dimembermatt/mighty-mppt/hardware/mppt/models/molex_43650_0315.stp

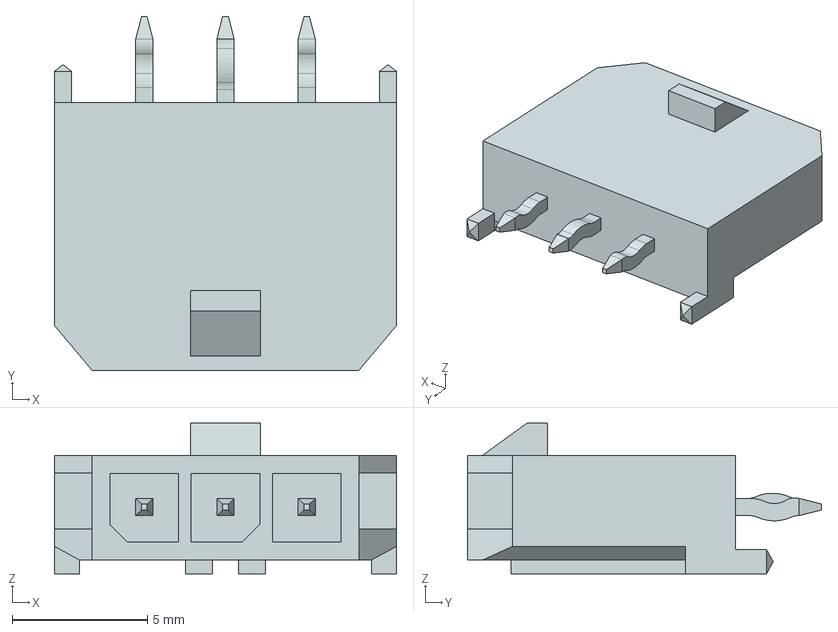
[picture p1: CAD file, 2024-09-21]
hardware/mppt/models/molex_43650_0315.stp
12.7 x 13.1 x 5.57 mm
