dimembermatt/mighty-mppt/hardware/mppt/symbols/tdk_B65878E1012D001.stp

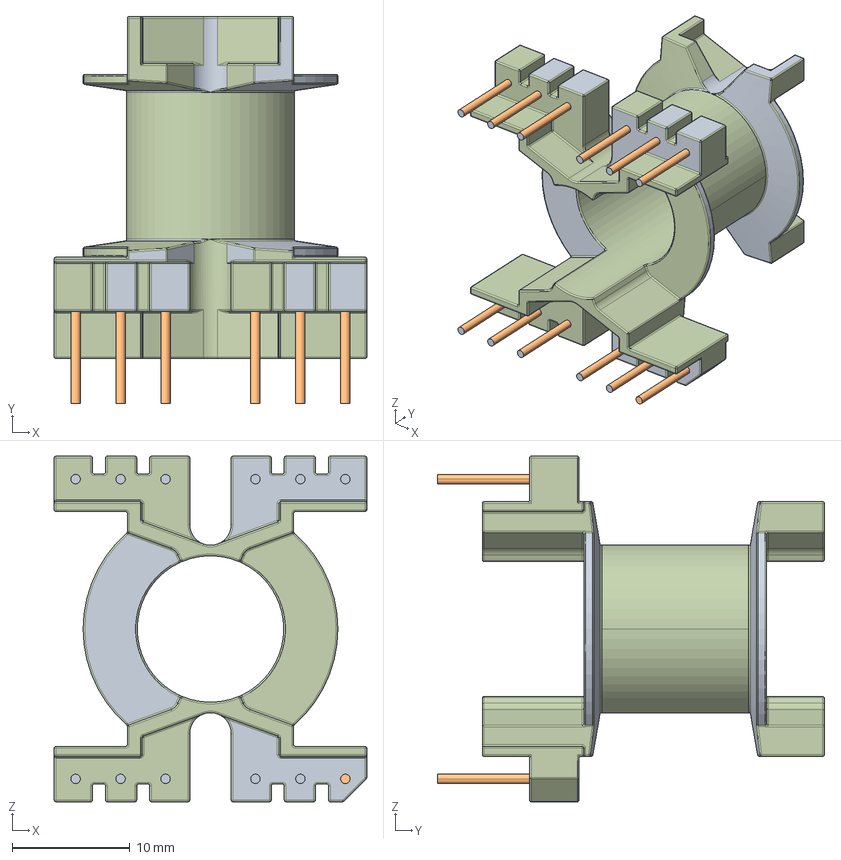
[picture p2: CAD file, 2024-09-21]
hardware/mppt/symbols/tdk_B65878E1012D001.stp
26.5 x 32.8 x 29.3 mm
