dimembermatt/mighty-mppt/hardware/mppt/models/molex_43650_0215.stp

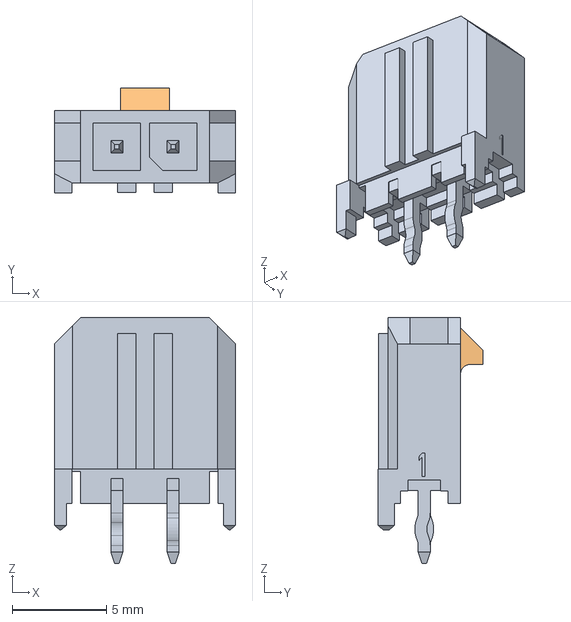
[picture p3: CAD file, 2024-09-21]
hardware/mppt/models/molex_43650_0215.stp
9.65 x 5.61 x 13.1 mm
