dimembermatt/mighty-mppt/hardware/mppt/models/molex_43650_0415.stp

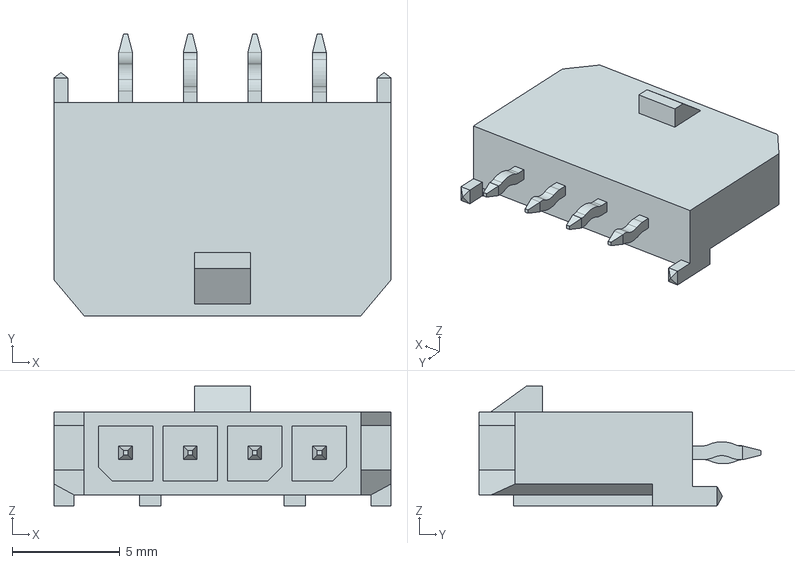
[picture p4: CAD file, 2024-09-21]
hardware/mppt/models/molex_43650_0415.stp
15.7 x 13.1 x 5.57 mm
