dimembermatt/mighty-mppt/hardware/mppt/models/abracon_ABS2.step

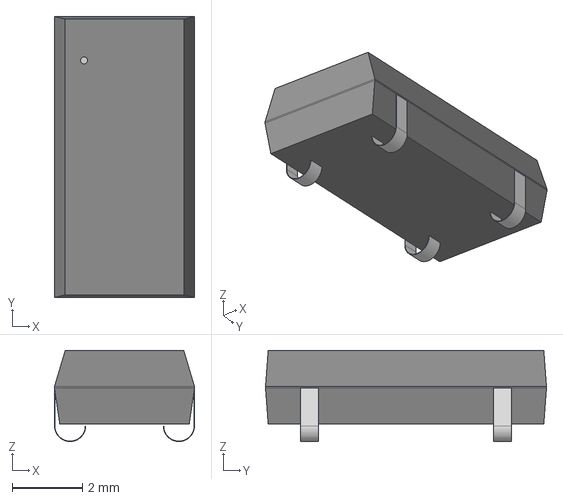
[picture p5: CAD file, 2024-09-21]
hardware/mppt/models/abracon_ABS2.step
3.99 x 8.00 x 2.59 mm
