dimembermatt/mighty-mppt/hardware/mppt/models/ke_7771_SEMS.stp

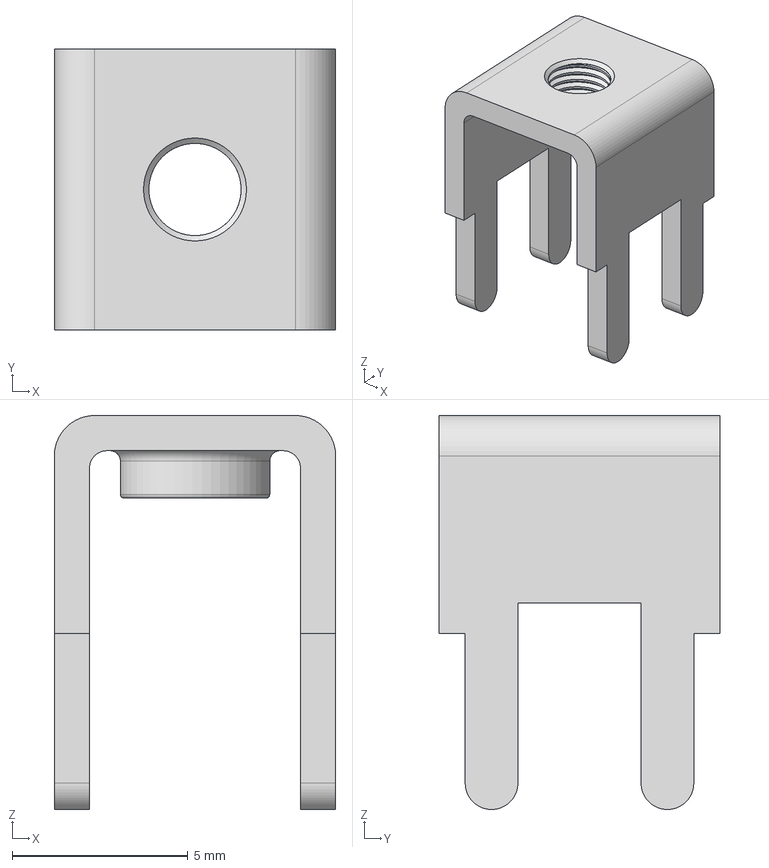
[picture p6: CAD file, 2024-09-02]
hardware/mppt/models/ke_7771_SEMS.stp
8.00 x 8.00 x 11.2 mm
