dimembermatt/mighty-mppt/hardware/mppt/models/ti_SN74HCS367_PWR.stp

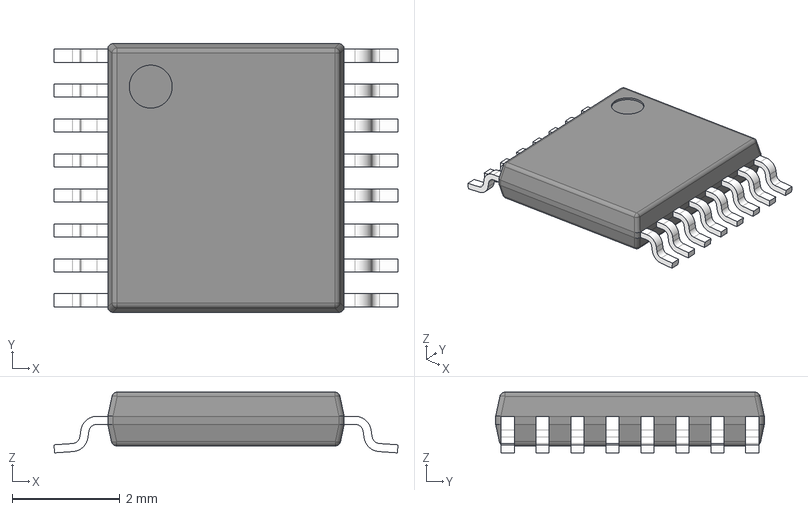
[picture p7: CAD file, 2024-08-27]
hardware/mppt/models/ti_SN74HCS367_PWR.stp
6.40 x 5.00 x 1.13 mm
BODY-TSSOP
LEAD-TSSOP x 16
PIN1
