dimembermatt/mighty-mppt/hardware/mppt/models/ti_ISO6720B_DR.stp

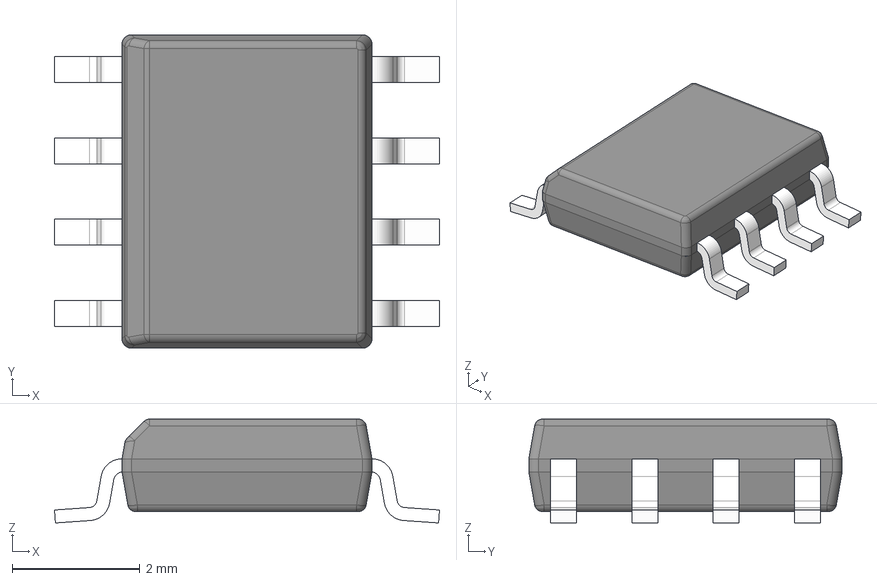
[picture p8: CAD file, 2024-08-27]
hardware/mppt/models/ti_ISO6720B_DR.stp
6.02 x 4.90 x 1.63 mm
BODY-SO
LEAD-D0008B x 8
