dimembermatt/mighty-mppt/hardware/mppt/models/ti_SN74LVC2G32_DCUR.stp

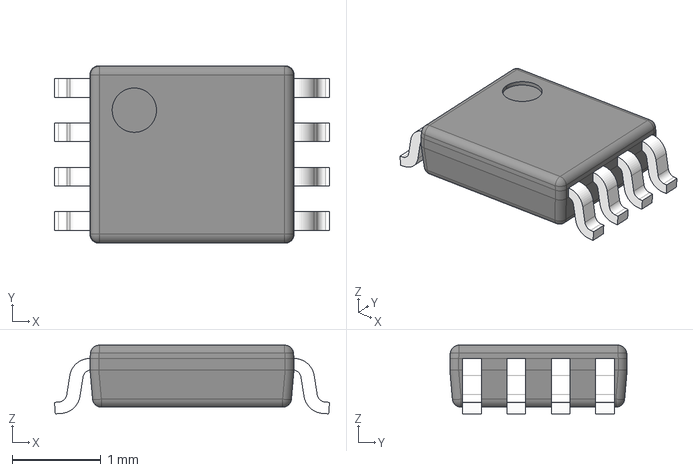
[picture p9: CAD file, 2024-08-27]
hardware/mppt/models/ti_SN74LVC2G32_DCUR.stp
3.10 x 2.00 x 0.775 mm
BODY-VSSOP
LEAD-VSSOP x 8
