dimembermatt/mighty-mppt/hardware/mppt/models/ti_INA229_AIDGSR.stp

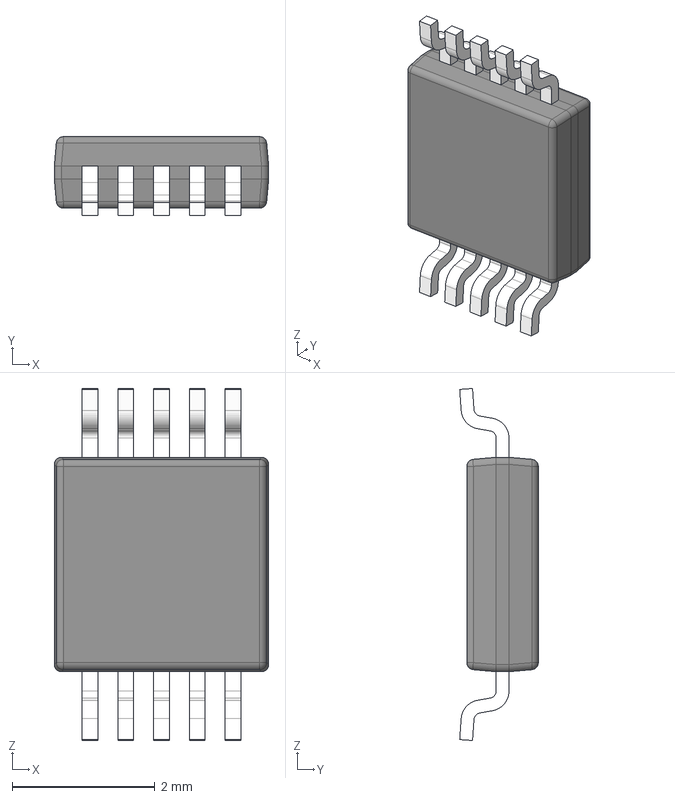
[picture p10: CAD file, 2024-08-27]
hardware/mppt/models/ti_INA229_AIDGSR.stp
3.00 x 1.10 x 4.93 mm
BODY-SO
LEAD-SO x 10
PIN1-ID
