dimembermatt/mighty-mppt/hardware/mppt/models/ti_TPS3050_DWZ.stp

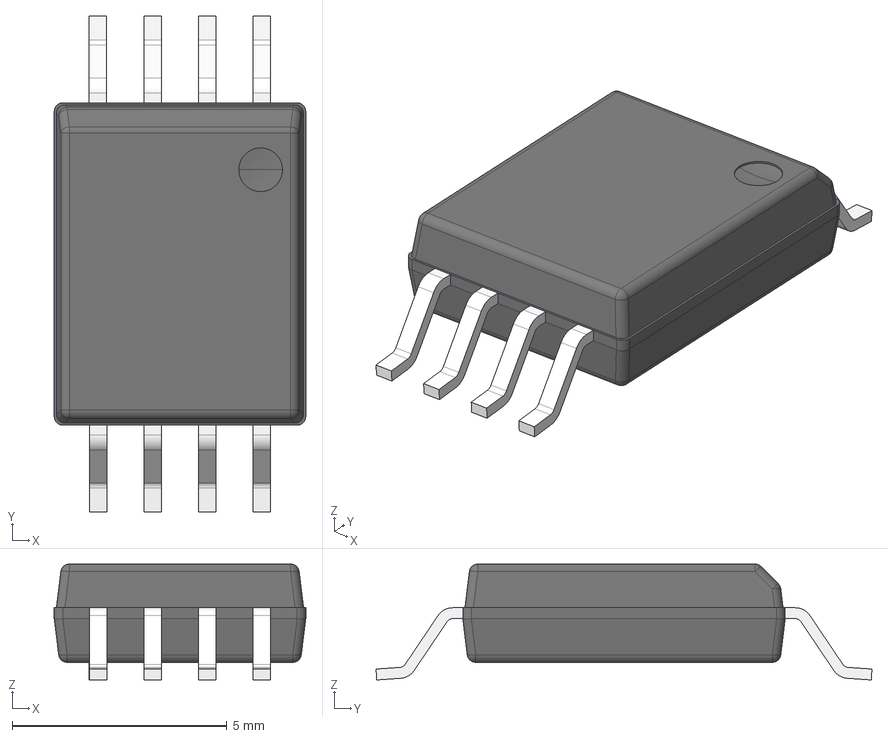
[picture p11: CAD file, 2024-08-27]
hardware/mppt/models/ti_TPS3050_DWZ.stp
5.85 x 11.5 x 2.70 mm
BODY-SOIC
LEAD x 8
