dimembermatt/mighty-mppt/hardware/mppt/models/ti_SN74LVC08A_PWR.stp

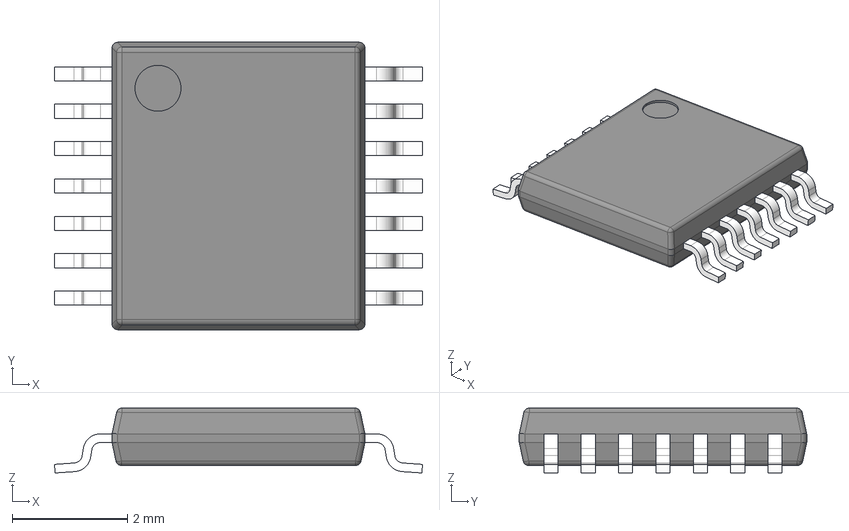
[picture p12: CAD file, 2024-08-27]
hardware/mppt/models/ti_SN74LVC08A_PWR.stp
6.40 x 5.00 x 1.13 mm
BODY-TSSOP
LEAD-TSSOP x 14
PIN1
