dimembermatt/mighty-mppt/hardware/mppt/models/ti_SN74LVC1G04_DBVR.stp

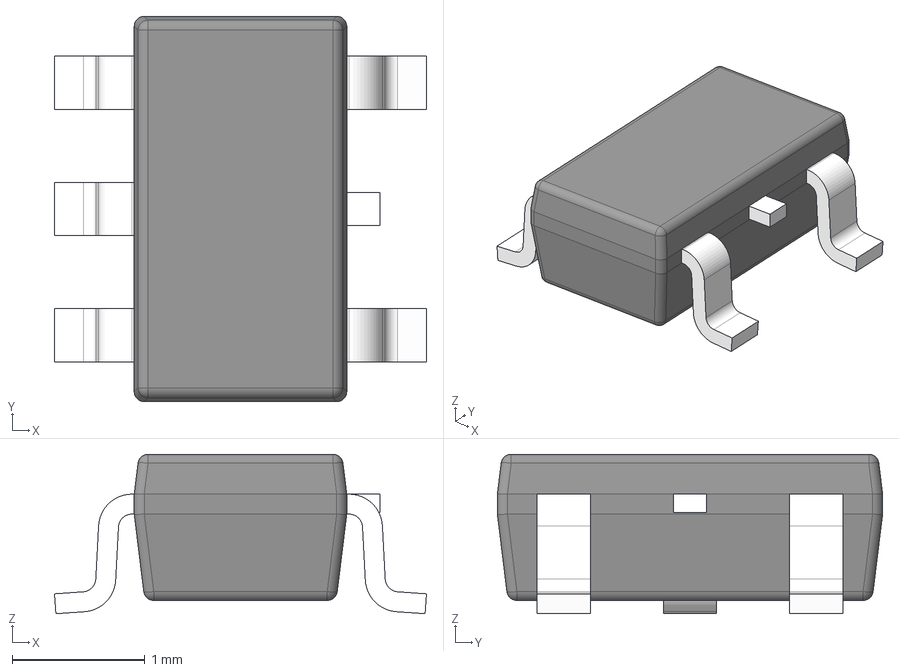
[picture p13: CAD file, 2024-08-27]
hardware/mppt/models/ti_SN74LVC1G04_DBVR.stp
2.80 x 2.90 x 1.20 mm
BODY-SOT
LEAD-SOT x 5
LEAD-DUMMY
