dimembermatt/mighty-mppt/hardware/mppt/models/ferroxcube_CPV-PQ32_20-1S-12P-Z.stp

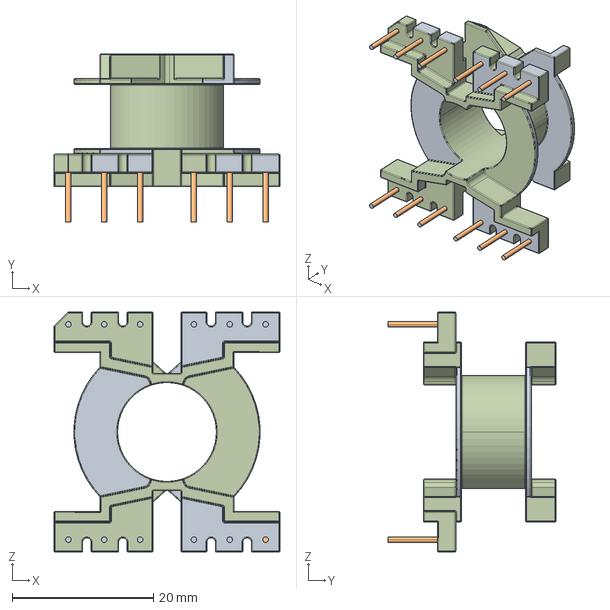
[picture p14: CAD file, 2024-08-25]
hardware/mppt/models/ferroxcube_CPV-PQ32_20-1S-12P-Z.stp
32.0 x 23.8 x 34.0 mm
