dimembermatt/mighty-mppt/hardware/mppt/models/bourns_PV36W104C01B00.stp

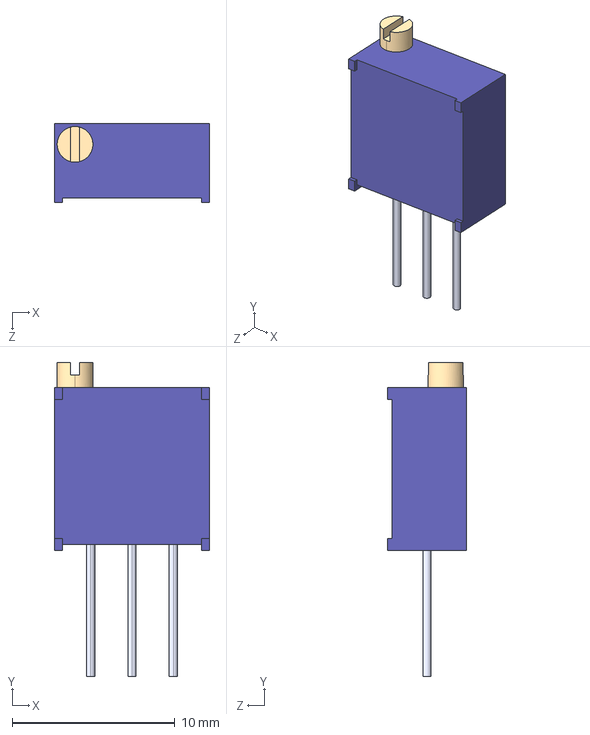
[picture p15: CAD file, 2024-08-25]
hardware/mppt/models/bourns_PV36W104C01B00.stp
9.53 x 19.3 x 4.83 mm
