dimembermatt/mighty-mppt/hardware/mppt/models/epc_EPC2059.step

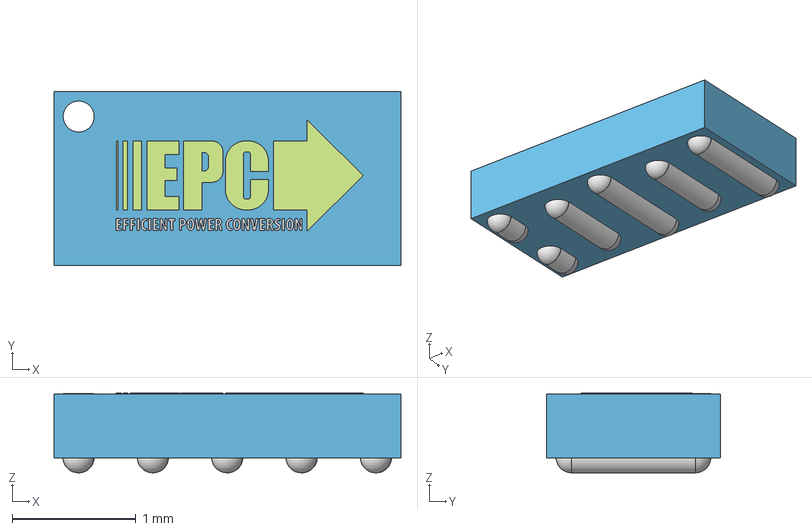
[picture p16: CAD file, 2024-08-25]
hardware/mppt/models/epc_EPC2059.step
2.80 x 1.40 x 0.643 mm
2mm
2mm001
2mm002
2mm003
2mm004
2mm005
2mm006
Extruded
