dimembermatt/mighty-mppt/hardware/mppt/models/keystone_electronics_7771_SEMS.step

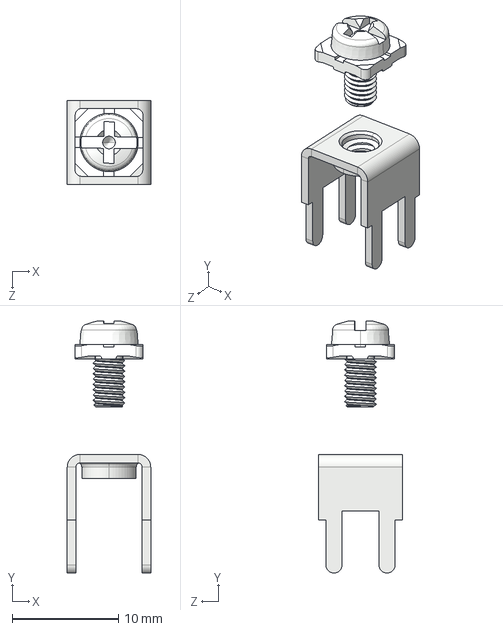
[picture p17: CAD file, 2024-08-25]
hardware/mppt/models/keystone_electronics_7771_SEMS.step
7.87 x 23.8 x 7.87 mm
