dimembermatt/mighty-mppt/hardware/mppt/models/ad_ADUM4221_1ARIZ.step

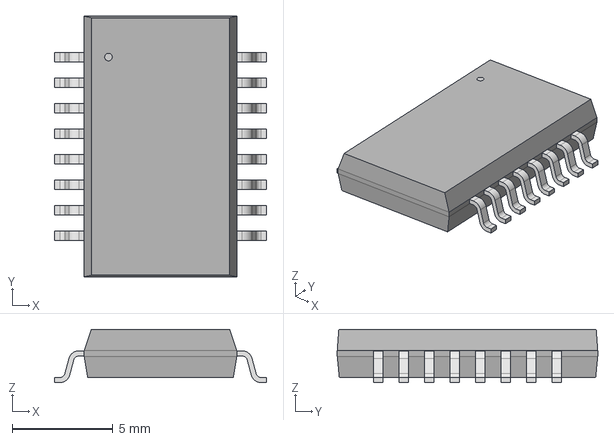
[picture p18: CAD file, 2024-08-25]
hardware/mppt/models/ad_ADUM4221_1ARIZ.step
10.5 x 13.0 x 2.64 mm
