dimembermatt/mighty-mppt/hardware/mppt/models/stm_STPS1170AF.stp

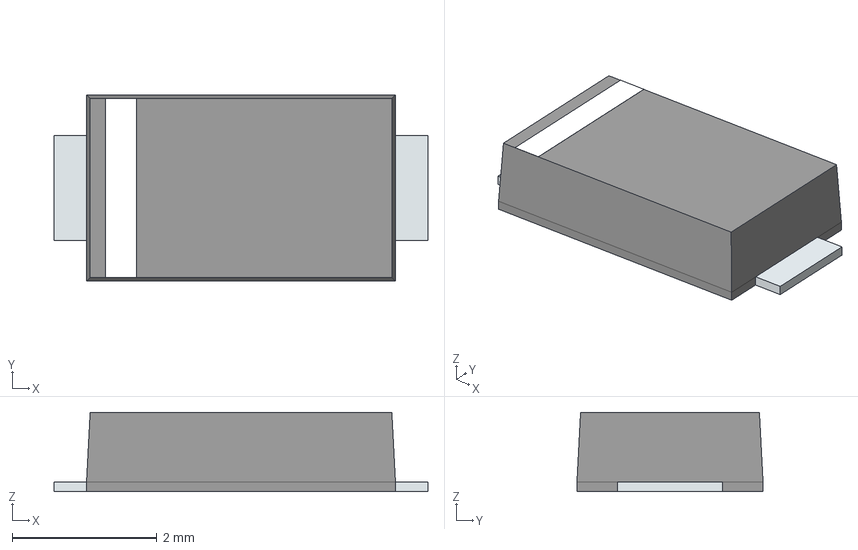
[picture p19: CAD file, 2024-08-25]
hardware/mppt/models/stm_STPS1170AF.stp
5.17 x 2.58 x 1.10 mm
PinKIdent
PinK
PinA
