dimembermatt/mighty-mppt/hardware/mppt/models/littelfuse_65600001009.stp

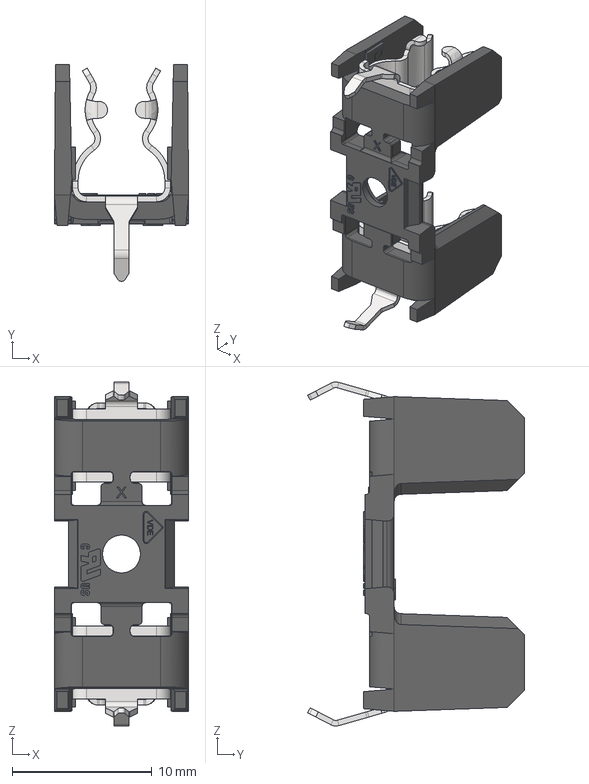
[picture p20: CAD file, 2024-08-25]
hardware/mppt/models/littelfuse_65600001009.stp
9.60 x 15.5 x 24.6 mm
