dimembermatt/mighty-mppt/hardware/mppt/models/ti_LMR38010_SDDAR.stp

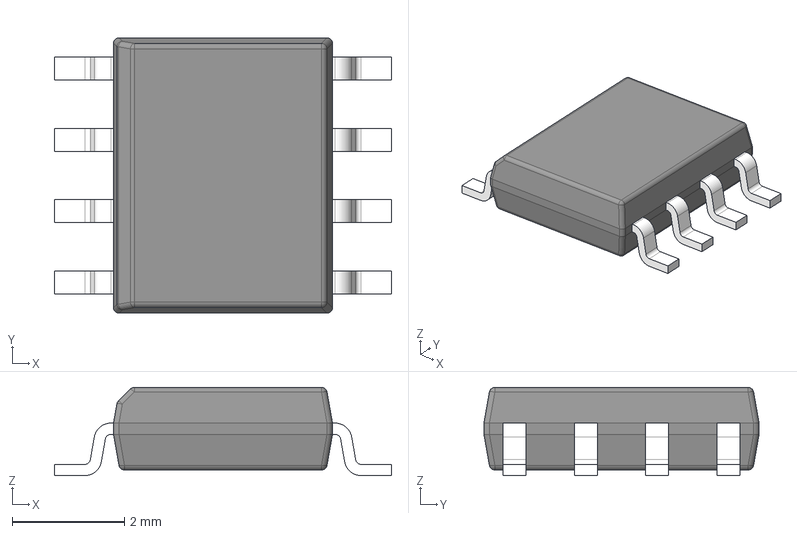
[picture p21: CAD file, 2024-08-25]
hardware/mppt/models/ti_LMR38010_SDDAR.stp
6.00 x 4.90 x 1.57 mm
BODY-SO
LEAD-SO x 8
THERMALPAD-SO
