dimembermatt/mighty-mppt/hardware/mppt/models/caltest_ct3151_0.stp

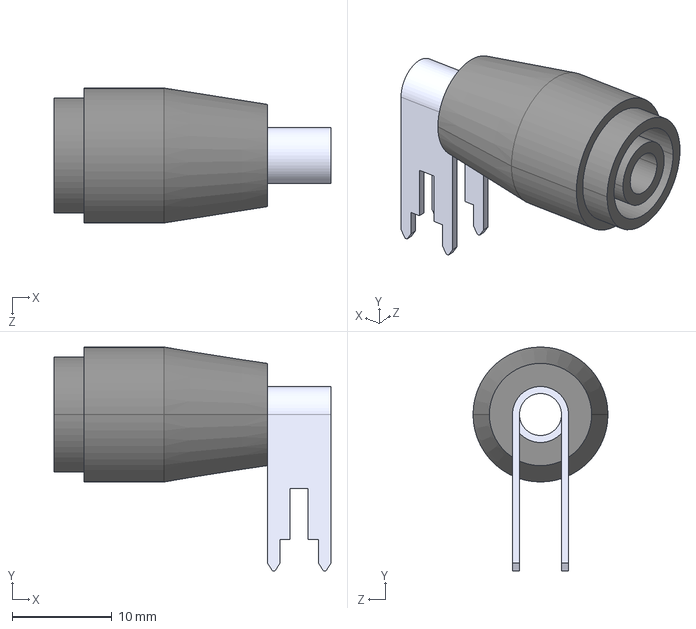
[picture p22: CAD file, 2024-08-25]
hardware/mppt/models/caltest_ct3151_0.stp
27.7 x 22.4 x 13.5 mm
