dimembermatt/mighty-mppt/hardware/mppt/models/murata_CRE1_S0505MEC.stp

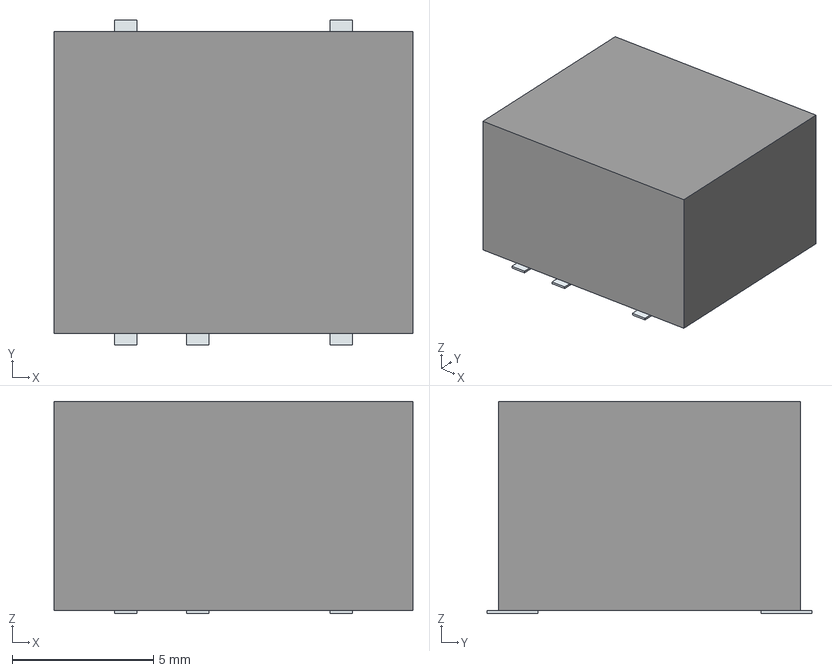
[picture p23: CAD file, 2024-08-25]
hardware/mppt/models/murata_CRE1_S0505MEC.stp
12.7 x 11.5 x 7.50 mm
Pins
