dimembermatt/mighty-mppt/hardware/mppt/models/ti_TPS2121_RUXR.stp

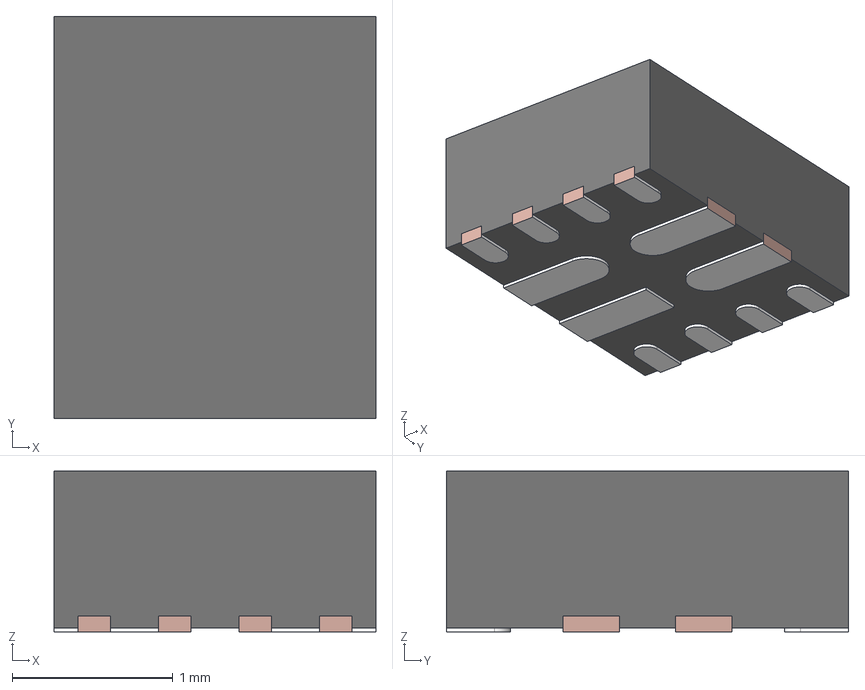
[picture p24: CAD file, 2024-08-25]
hardware/mppt/models/ti_TPS2121_RUXR.stp
2.00 x 2.50 x 1.00 mm
FRAME
MOLD
