dimembermatt/mighty-mppt/(list of files, cad)

Other CAD files:
hardware/mppt/models/caltest_ct3151_2.step
