dimembermatt/mighty-mppt/hardware/mppt/mppt.kicad_pcb

## KiCad design hardware/mppt/mppt.kicad_pcb (2024-09-21)

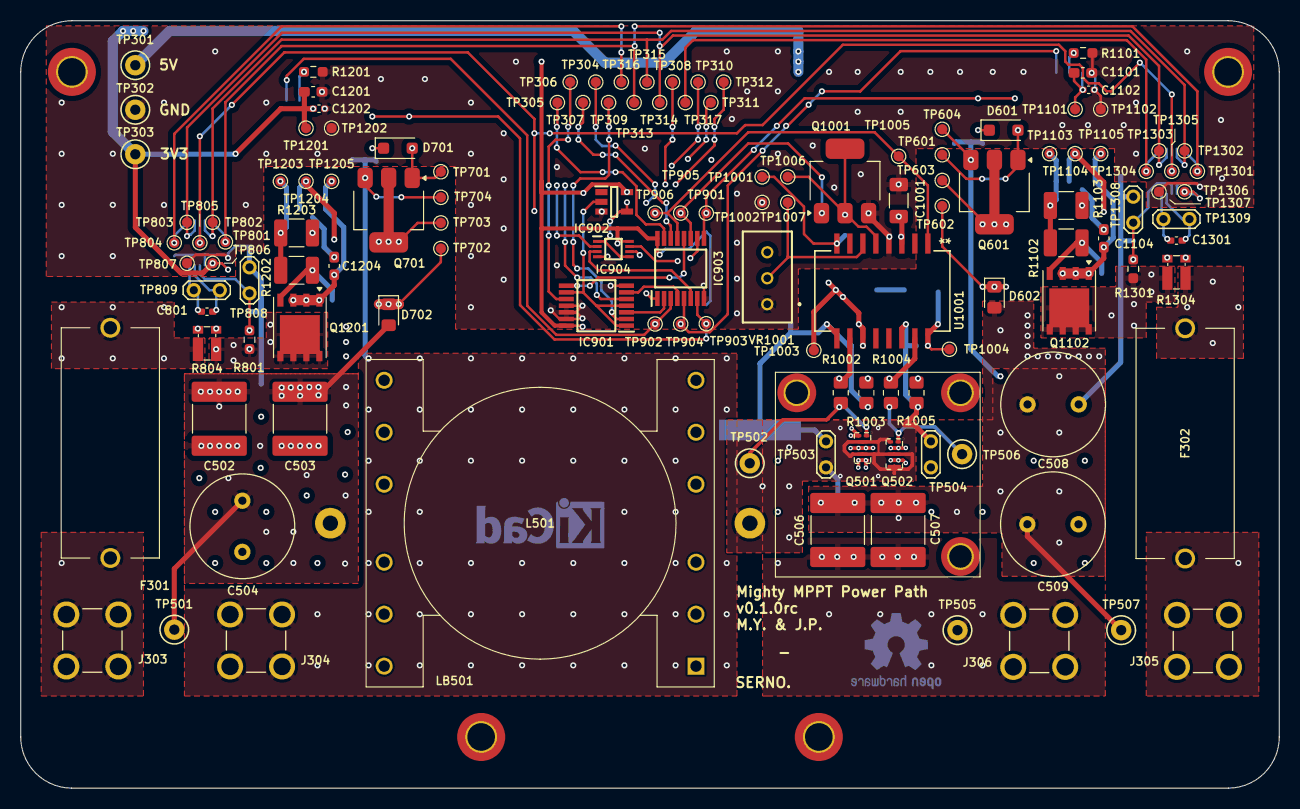
[picture p25: board mppt.kicad_pcb from above]

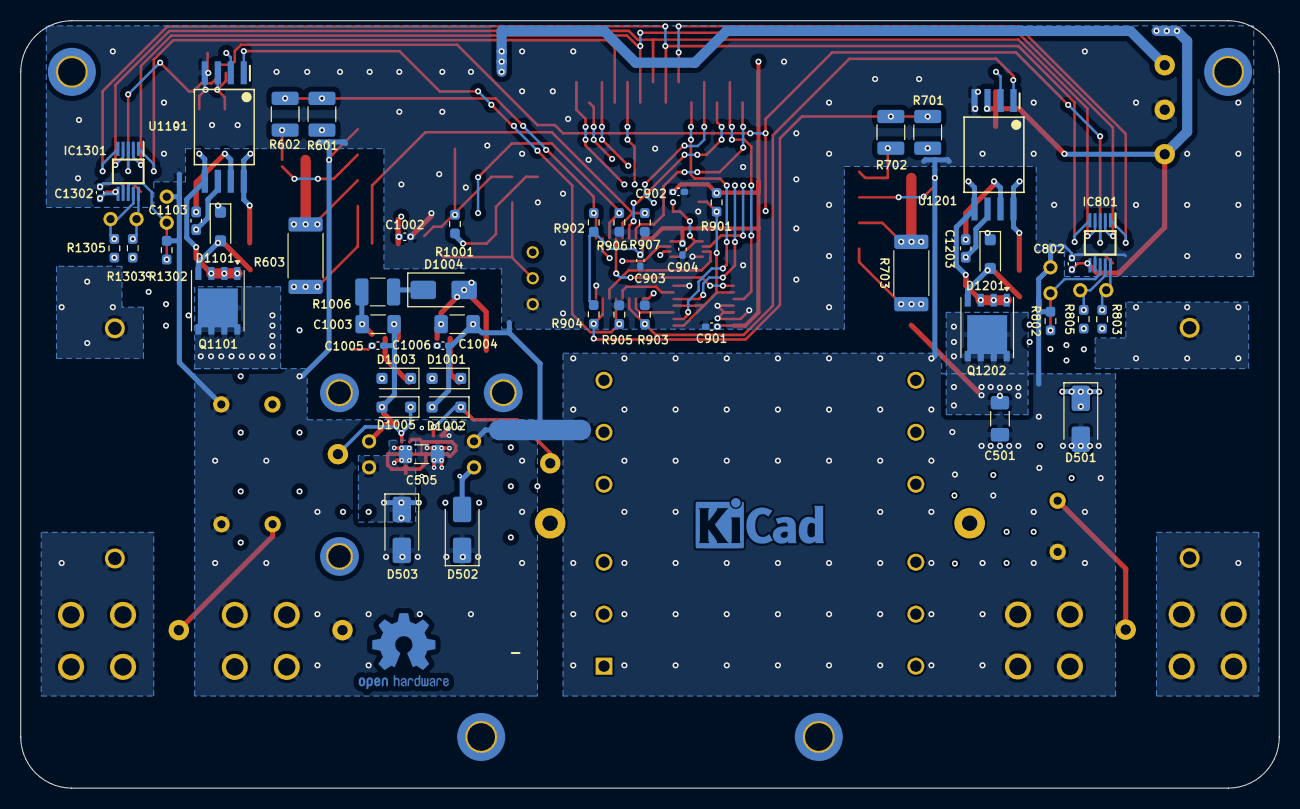
[picture p26: board mppt.kicad_pcb from below]

Board: 4 copper layers, 123.0 x 75.0 mm, 193 parts (58 on the bottom side), 83 nets.

Parts:
C501, C505: 100n; C_1206_3216Metric_Pad1.33x1.80mm_HandSolder
C502, C506: 1u; C_2220_5750Metric_Pad1.97x5.40mm_HandSolder
C503, C507: 2.2u; C_2220_5750Metric_Pad1.97x5.40mm_HandSolder
C504, C508, C509: 18u; C_Radial_D10.0mm_H16.0mm_P5.00mm
C801, C802, C901, C902, C903, C904, C1002, C1005, C1006, C1102, C1202, C1301, C1302: 100n; C_0402_1005Metric_Pad0.74x0.62mm_HandSolder
C1001, C1003, C1004: 10u; C_1206_3216Metric_Pad1.33x1.80mm_HandSolder
C1101, C1103, C1104, C1201, C1203, C1204: 1u; C_0603_1608Metric_Pad1.08x0.95mm_HandSolder
D501, D503: 150; D_SMA
D502: SMAJ150CA; D_SMA
D601, D701, D1001, D1003, D1101, D1201: Schottky; D_SOD-123F
D602, D702: BLU; LED_0805_2012Metric_Pad1.15x1.40mm_HandSolder
D1002, D1005: Zener; D_SOD-123F
D1004: 0.62V; D_SMA
F301, F302: Fuse; littelfuse_65600001009
H101, H102, H103, H104: MountingHole; MountingHole_2.7mm_M2.5_DIN965_Pad_TopBottom
H401, H402, H403: MountingHole; MountingHole_2.2mm_M2_DIN965_Pad_TopBottom
IC801, IC1301: INA229AIDGSR; ti_INA229_AIDGSR
IC901: SN74LVC08APWR; ti_SN74LVC08A_PWR
IC902: SN74LVC1G04DBVR; ti_SN74LVC1G04_DBVR
IC903: SN74HCS367PWR; ti_SN74HCS367_PWR
IC904: SN74LVC2G32DCUR; ti_SN74LVC2G32_DCUR
J303, J304, J305, J306: CT3151; caltest_ct3151
L501: 471u; ferroxcube_PQ32_20_3C97_wire
LB501: CPV-PQ32/20-1S-12PD-Z; ferroxcube_CPV-PQ32_20-1S-12P-Z
NT501: NetTie_3_Tee; NetTie-3_SMD_Pad2.0mm
NT601, NT701, NT801, NT1001, NT1301: NetTie_2; NetTie-2_SMD_Pad0.5mm
Q501, Q502: EPC2059; epc_EPC2059
Q601, Q701, Q1001: Q_NMOS_GDS; SOT-223-3_TabPin2
Q1101, Q1102, Q1201, Q1202: Q_NMOS_SGD; PowerPAK_SO-8_Single
R601, R602, R701, R702, R1102, R1103, R1202, R1203: 15; R_1210_3225Metric_Pad1.30x2.65mm_HandSolder
R603, R703: 10k; R_2512_6332Metric_Pad1.40x3.35mm_HandSolder
R801, R1301: 86.6k; R_0603_1608Metric_Pad0.98x0.95mm_HandSolder
R802, R901, R902, R903, R904, R905, R906, R907, R1001, R1302: 100k; R_0603_1608Metric_Pad0.98x0.95mm_HandSolder
R803, R805, R1303, R1305: 15; R_0603_1608Metric_Pad0.98x0.95mm_HandSolder
R804, R1304: 4m; R_Shunt_Vishay_WSKW0612
R1002, R1003, R1004, R1005: 0; R_0805_2012Metric_Pad1.20x1.40mm_HandSolder
R1006: 1.5; R_1210_3225Metric_Pad1.30x2.65mm_HandSolder
R1101, R1201: 7.32k; R_0603_1608Metric_Pad0.98x0.95mm_HandSolder
TP301, TP302, TP303, TP501, TP502, TP505, TP506, TP507: TestPoint; TestPoint_Keystone_5000-5004_Miniature
TP304, TP305, TP306, TP307, TP308, TP309, TP310, TP311, TP312, TP313, TP314, TP315, TP316, TP317, TP601, TP602, TP603, TP604, TP701, TP702, TP703, TP704, TP801, TP802, TP803, TP804, TP805, TP806, TP807, TP901, TP902, TP903, TP904, TP905, TP906, TP1001, TP1002, TP1003, TP1004, TP1005, TP1006, TP1007, TP1101, TP1102, TP1103, TP1104, TP1105, TP1201, TP1202, TP1203, TP1204, TP1205, TP1301, TP1302, TP1303, TP1304, TP1305, TP1306, TP1307: TestPoint_Small; TestPoint_Pad_D1.0mm
TP503, TP504, TP808, TP809, TP1308, TP1309: TestPoint_2Pole; TestPoint_2Pads_Pitch2.54mm_Drill0.8mm
U1001: ADUM4221-1ARIZ; ad_ADUM4221_1ARIZ
U1101, U1201: TPSI3050; ti_TPS3050_DWZ
VR1001: PV36W104C01B00; bourns_PV36W201C01B00

Connections:
+3V3: C802.2, C901.1, C902.1, C903.1, C904.1, C1001.1, C1002.1, C1101.1, C1102.1, C1201.1, C1202.1, C1302.2, IC801.6 (VS), IC901.14 (VCC), IC902.5 (VCC), IC903.16 (VCC), IC904.8 (VCC), IC1301.6 (VS), R901.1, R902.1, R904.1, R1001.1, TP303.1, TP806.1, TP1001.1, TP1101.1, TP1201.1, TP1306.1, U1001.3 (VDD1), U1001.8 (VDD1), U1101.3 (VDDP), U1201.3 (VDDP)
+5V: C1004.1, C1006.1, D1004.2 (A), TP301.1, TP1003.1, U1001.11 (VDDB)
/AL_IN_EN: IC904.2 (1B), TP311.1
/AL_OUT_EN: IC904.6 (2B), TP312.1
/CONV_DISABLE: IC903.15 (~2OE), TP305.1
/CONV_EN: IC901.10 (3B), TP306.1
/CONV_PWM: IC903.14 (2A2), TP307.1
/LS_IN_EN: IC901.2 (1B), TP309.1
/LS_OUT_EN: IC901.5 (2B), TP310.1
/MON_ALERT: IC902.4 (Y), IC904.1 (1A), IC904.5 (2A), TP308.1
/MON_IN_CS: IC801.1 (CS), TP316.1, TP804.1
/MON_OUT_CS: IC1301.1 (CS), TP317.1, TP1304.1
/MON_SPI_CIPO: IC801.4 (MISO), IC1301.4 (MISO), TP315.1, TP802.1, TP1302.1
/MON_SPI_CLK: IC801.5 (SCLK), IC1301.5 (SCLK), TP313.1, TP801.1, TP1301.1
/MON_SPI_COPI: IC801.2 (MOSI), IC1301.2 (MOSI), TP314.1, TP803.1, TP1303.1
/PROT_DISABLE: IC903.1 (~1OE), TP304.1
/VI+: F301.2, R804.1
/VI-: C501.2, C502.2, C503.2, C504.2, D501.2 (A), J304.1, J304.2 (1), J304.3 (1), J304.4 (1), NT501.1, NT701.2, NT801.1, Q701.3 (S), R802.2, TP704.1, TP808.2
/power_converter/AL_SNK_EN_BUF: IC903.9 (1Y4), R601.2, R602.2, R902.2, TP901.1
/power_converter/AL_SRC_EN_BUF: IC903.7 (1Y3), R701.2, R702.2, R904.2, TP903.1
/power_converter/Active Load Sink/V+: C505.1, C506.1, C507.1, C508.1, C509.1, D503.1 (K), D602.2 (A), Q502.3 (D), Q502.5 (D), Q1101.3 (D), TP504.2, TP507.1
/power_converter/Active Load Source/V+: C501.1, C502.1, C503.1, C504.1, D501.1 (K), D702.2 (A), L501.1, Q1202.3 (D), TP501.1
/power_converter/Gate Driver/CONV_EN: IC903.11 (2Y1), Q1001.1 (G), R906.1, TP905.1
/power_converter/Gate Driver/CONV_PWM: IC903.13 (2Y2), R907.1, TP906.1, TP1005.1, U1001.1 (PWM)
/power_converter/Gate Driver/DISABLE: Q1001.2 (D), R1001.2, TP1006.1, U1001.5 (DISABLE)
/power_converter/Gate Driver/DT: TP1007.1, U1001.6 (DT), VR1001.2 (WIPER)
/power_converter/Gate Driver/VDDA: C1003.1, C1005.1, R1006.2, TP1004.1, U1001.16 (VDDA)
/power_converter/Gate Driver/VOA: D1003.1 (K), R1004.1, U1001.15 (VOA)
/power_converter/Gate Driver/VOB: D1001.1 (K), R1002.1, U1001.10 (VOB)
/power_converter/LS_SNK_EN_BUF: IC903.5 (1Y2), R905.1, TP904.1, U1101.1 (EN)
/power_converter/LS_SRC_EN_BUF: IC903.3 (1Y1), R903.1, TP902.1, U1201.1 (EN)
/power_converter/Load Switch Sink/I+: Q1201.3 (D), R801.1, R804.4
/power_converter/Load Switch Sink/VDDH: C1203.1, TP1204.1, U1201.7 (VDDH)
/power_converter/Load Switch Sink/VDRV: R1202.2, R1203.2, TP1203.1, U1201.8 (VDRV)
/power_converter/Load Switch Sink/VSSS: C1204.2, Q1201.1 (S), Q1202.1 (S), TP1205.1, U1201.5 (VSSS)
/power_converter/Load Switch Source/I-: Q1102.3 (D), R1301.1, R1304.1
/power_converter/Load Switch Source/VDDH: C1103.1, TP1104.1, U1101.7 (VDDH)
/power_converter/Load Switch Source/VDRV: R1102.2, R1103.2, TP1103.1, U1101.8 (VDRV)
/power_converter/Load Switch Source/VSSS: C1104.2, Q1101.1 (S), Q1102.1 (S), TP1105.1, U1101.5 (VSSS)
/power_converter/OUT+: F302.1, J305.1, J305.2 (1), J305.3 (1), J305.4 (1)
/power_converter/OUT-: C505.2, C506.2, C507.2, C508.2, C509.2, D502.1 (A1), D503.2 (A), J306.1, J306.2 (1), J306.3 (1), J306.4 (1), NT501.3, NT601.2, NT1301.1, Q501.2 (S), Q501.4 (S), Q501.6 (S), Q601.3 (S), R1302.2, TP503.1, TP505.1, TP604.1, TP1308.2
/power_converter/Power Monitor Sink/I-: F302.2, R1304.4
/power_converter/Power Monitor Sink/IN+: C1301.2, IC1301.10 (IN+), R1303.1, TP1309.1
/power_converter/Power Monitor Sink/IN-: C1301.1, IC1301.9 (IN-), R1305.1, TP1309.2
/power_converter/Power Monitor Sink/VBUS: IC1301.8 (VBUS), R1301.2, R1302.1, TP1308.1
/power_converter/Power Monitor Source/IN+: C801.2, IC801.10 (IN+), R803.1, TP809.1
/power_converter/Power Monitor Source/IN-: C801.1, IC801.9 (IN-), R805.1, TP809.2
/power_converter/Power Monitor Source/VBUS: IC801.8 (VBUS), R801.2, R802.1, TP808.1
/power_converter/Protection Logic/AL_SNK_EN_OR: IC903.10 (1A4), IC904.7 (1Y)
/power_converter/Protection Logic/AL_SRC_EN_OR: IC903.6 (1A3), IC904.3 (2Y)
/power_converter/Protection Logic/CONV_EN_AND: IC901.8 (3Y), IC903.12 (2A1)
/power_converter/Protection Logic/LS_SNK_EN_AND: IC901.6 (2Y), IC903.4 (1A2)
/power_converter/Protection Logic/LS_SRC_EN_AND: IC901.3 (1Y), IC903.2 (1A1)
/power_converter/SWH: D1005.1 (K), Q502.1 (G), R1004.2, TP506.1
/power_converter/SWL: D1002.1 (K), Q501.1 (G), R1002.2, TP502.1
/power_converter/VSW: C1003.2, C1005.2, D502.2 (A2), D1005.2 (A), L501.2, Q501.3 (D), Q501.5 (D), Q502.2 (S), Q502.4 (S), Q502.6 (S), R1005.2, TP503.2, TP504.1, U1001.14 (GNDA)
/power_converter/_IN+: F301.1, J303.1, J303.2 (1), J303.3 (1), J303.4 (1)
/power_converter/~MON_ALERT: IC801.3 (ALERT), IC901.1 (1A), IC901.4 (2A), IC901.9 (3A), IC902.2 (A), IC1301.3 (ALERT), R901.2, TP805.1, TP1305.1
GND: C802.1, C901.2, C902.2, C903.2, C904.2, C1001.2, C1002.2, C1101.2, C1102.2, C1201.2, C1202.2, C1302.1, IC801.7 (GND), IC901.7 (GND), IC901.11 (4Y), IC901.12 (4A), IC901.13 (4B), IC902.3 (GND), IC903.8 (GND), IC904.4 (GND), IC1301.7 (GND), NT601.1, NT701.1, NT801.2, NT1001.1, NT1301.2, Q1001.3 (S), R903.2, R905.2, R906.2, R907.2, R1101.2, R1201.2, TP302.1, TP807.1, TP1002.1, TP1102.1, TP1202.1, TP1307.1, U1001.4 (GND1), U1101.4 (VSSP), U1201.4 (VSSP), VR1001.1 (CCW)
GNDPWR: C1004.2, C1006.2, D1002.2 (A), NT501.2, NT1001.2, R1003.2, U1001.9 (GNDB)
unnamed: D601.2 (A), Q601.1 (G), R602.1, TP601.1
unnamed: D601.1 (K), R601.1
unnamed: D602.1 (K), R603.1, TP602.1
unnamed: D701.2 (A), Q701.1 (G), R702.1, TP701.1
unnamed: D701.1 (K), R701.1
unnamed: D702.1 (K), R703.1, TP702.1
unnamed: D1001.2 (A), R1003.1
unnamed: D1003.2 (A), R1005.1
unnamed: D1004.1 (K), R1006.1
unnamed: D1101.2 (A), Q1101.2 (G), Q1102.2 (G), R1102.1
unnamed: D1101.1 (K), R1103.1
unnamed: D1201.2 (A), Q1201.2 (G), Q1202.2 (G), R1202.1
unnamed: D1201.1 (K), R1203.1
unnamed: Q601.2 (D), R603.2, TP603.1
unnamed: Q701.2 (D), R703.2, TP703.1
unnamed: R803.2, R804.2
unnamed: R804.3, R805.2
unnamed: R1303.2, R1304.2
unnamed: R1304.3, R1305.2
unnamed: R1101.1, U1101.2 (PXFR)
unnamed: C1103.2, C1104.1, U1101.6 (VDDM)
unnamed: R1201.1, U1201.2 (PXFR)
unnamed: C1203.2, C1204.1, U1201.6 (VDDM)
