dimembermatt/mighty-mppt/USAGE.md

# USAGE

## How to use this repository

Designs are organized by release (or for unpublished designs, named branches).
Each release will maintain the following project structure:

- docs: Design documentation.
  - chapters: Discussion of project scope and design process, as well as usage
    guides.
  - datasheets: Repository of all major component datasheets used in the
    hardware repository.
  - notes: Additional documents, like system block diagrams, that inform the
    project design.
- firmware: Test and source firmware that runs on the hardware.
- hardware: Hardware designs in KiCAD.
- software: Additional software used for design and test but not actively
  running on hardware.
