dimembermatt/mighty-mppt/(commit log)

2024-08-25 power regulation breakout v0.1.0 rc
    [caltest_ct3151_0.stp, caltest_ct3151_2.step, mppt_power_regulation.kicad_pcb, mppt_power_regulation.kicad_sch, murata_CRE1_S0505MEC.stp, ti_LMR38010_SDDAR.stp, ti_TPS2121_RUXR.stp]
2024-08-25 gave names to unlabeled nets
    [mppt_power_regulation.kicad_pcb, mppt_power_regulation.kicad_sch]
2024-08-25 moved testpoints from between connectors to free space on board, added labels under banana jacks
    [mppt_power_regulation.kicad_pcb, mppt_power_regulation.kicad_sch]
2024-08-25 Converter breakout.
    [ad_ADUM4221_1ARIZ.step, bourns_PV36W104C01B00.stp, caltest_ct3151_0.stp, caltest_ct3151_2.step, epc_EPC2059.step, ferroxcube_CPV-PQ32_30-1S-12P-Z.stp, keystone_electronics_7771_SEMS.step, littelfuse_65600001009.stp]
2024-08-26 update bom to remove lcsc dependency
    [mppt_power_regulation.kicad_pcb, mppt_power_regulation.kicad_sch]
2024-08-26 changed layout of switching loop planes, added small 100n capacitors on HV input and output
    [mppt_converter.kicad_pcb, mppt_converter.kicad_sch]
2024-08-26 changed shapes of converter power planes, added small 100n capacitors to HV input and output capacitance
2024-08-27 init schematic for controller and power path
    [caltest_ct3151_0.stp, caltest_ct3151_2.step, mppt_controller.kicad_pcb, mppt_controller.kicad_sch, mppt_converter.kicad_sch, mppt_power_path.kicad_pcb, mppt_power_path.kicad_sch, ti_INA229_AIDGSR.stp]
2024-08-27 fix drc errors introduced into converter, power reg
    [mppt_converter.kicad_pcb, mppt_converter.kicad_sch, mppt_power_regulation.kicad_pcb, mppt_power_regulation.kicad_sch]
2024-08-28 revise sch and bom for power path, prelim layout, prelim documentation structure
    [mppt_power_path.kicad_pcb, mppt_power_path.kicad_sch]
2024-08-28 init sch build of main project
    [DCDC.kicad_sch, active_load.kicad_sch, ad_ADUM4221_1ARIZ.step, bourns_PV36W104C01B00.stp, caltest_ct3151_0.stp, caltest_ct3151_2.step, controller.kicad_sch, epc_EPC2059.step]
2024-09-01 run through mppt sch, going through bom
    [DCDC.kicad_sch, active_load.kicad_sch, communication_interfaces.kicad_sch, controller.kicad_sch, gate_driver.kicad_sch, load_switch.kicad_sch, mppt.kicad_pcb, mppt.kicad_sch]
2024-09-01 update final missing pieces for sch, moving to bom pop
    [DCDC.kicad_sch, active_load.kicad_sch, communication_interfaces.kicad_sch, controller.kicad_sch, gate_driver.kicad_sch, load_switch.kicad_sch, mppt.kicad_pcb, power_converter.kicad_sch]
2024-09-02 bom consolidated, starting layout
    [DCDC.kicad_sch, active_load.kicad_sch, communication_interfaces.kicad_sch, controller.kicad_sch, gate_driver.kicad_sch, ke_7771_SEMS.stp, load_switch.kicad_sch, mppt.kicad_pcb]
2024-09-02 progress on layout
    [mppt.kicad_pcb, power_converter.kicad_sch, power_monitor.kicad_sch]
2024-09-03 placement of majority of power path
    [DCDC.kicad_sch, gate_driver.kicad_sch, mppt.kicad_pcb, thermals.kicad_sch]
2024-09-07 PCB variant for power regulation breakout.
    [DCDC.kicad_sch, active_load.kicad_sch, ad_ADUM4221_1ARIZ.step, bourns_PV36W104C01B00.stp, caltest_ct3151_0.stp, caltest_ct3151_2.step, communication_interfaces.kicad_sch, controller.kicad_sch]
2024-09-08 complete layout, drc, signaling optimizations and added dnp testpoints
    [abracon_ABS2.step, communication_interfaces.kicad_sch, controller.kicad_sch, molex_43650_0315.stp, molex_43650_0415.stp, mppt.kicad_pcb, mppt.kicad_sch, power_converter.kicad_sch]
2024-09-21 converter schematic and layout.
    [DCDC.kicad_sch, active_load.kicad_sch, communication_interfaces.kicad_sch, controller.kicad_sch, ferroxcube_CPV-PQ32_20-1S-12P-Z.stp, gate_driver.kicad_sch, load_switch.kicad_sch, mppt.kicad_pcb]
